castortut/GeneralStepperMotorControllerPCB/README.md

# GeneralStepperMotorControllerPCB
Designed for can opener. Uses Arduino Nano and drv8825 / A4988

# TODO
- The power supply pins are the wrong way around in the PCB!
