castortut/GeneralStepperMotorControllerPCB/canopener.kicad_pcb

## KiCad design canopener.kicad_pcb (2023-08-17)

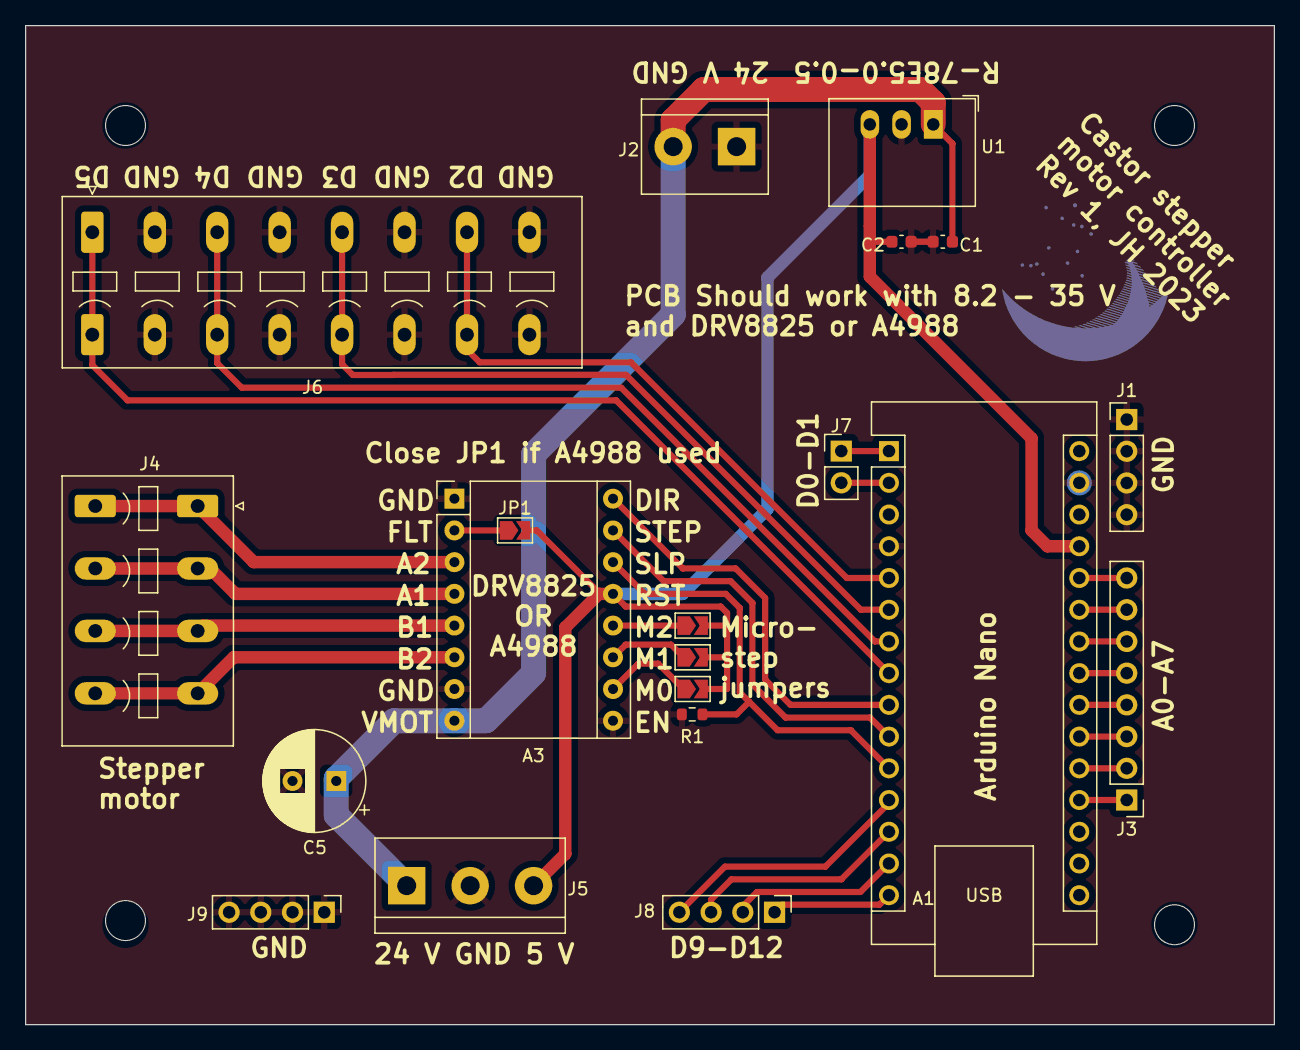
[picture p1: board canopener.kicad_pcb from above]

Board: 2 copper layers, 100.0 x 80.0 mm, 25 parts (1 on the bottom side), 32 nets.

Parts:
A1: Arduino_Nano_v3.x; Arduino_Nano
A3: Pololu_Breakout_DRV8825; Pololu_Breakout-16_15.2x20.3mm
C1, C2: 10u; C_0603_1608Metric
C5: 100u; CP_Radial_D8.0mm_P3.50mm
H1, H2, H3, H4: MountingHole; MountingHole_3.2mm_M3
J1, J8, J9: Conn_01x04; PinHeader_1x04_P2.54mm_Vertical
J2: Screw_Terminal_01x02; TerminalBlock_bornier-2_P5.08mm
J3: Conn_01x08; PinHeader_1x08_P2.54mm_Vertical
J4: Screw_Terminal_01x04; PhoenixContact_SPT_2.5_4-V-5.0-EX_1x04_P5.0mm_Vertical
J5: Screw_Terminal_01x03; TerminalBlock_bornier-3_P5.08mm
J6: Screw_Terminal_01x08; PhoenixContact_SPT_2.5_8-V-5.0-EX_1x08_P5.0mm_Vertical
J7: Conn_01x02; PinHeader_1x02_P2.54mm_Vertical
JP1: Jumper_2_Open; SolderJumper-2_P1.3mm_Open_TrianglePad1.0x1.5mm
LOGO1: CASTOR; Castor logo
M0, M1, M2: Jumper_2_Open; SolderJumper-2_P1.3mm_Open_TrianglePad1.0x1.5mm
R1: R; R_0603_1608Metric
U1: R-78E5.0-0.5; Converter_DCDC_RECOM_R-78E-0.5_THT

Connections:
+5V: A1.27 (+5V), A3.13 (~RST), C2.1, J5.3, JP1.2 (B), M0.2 (B), M1.2 (B), M2.2 (B), U1.3 (OUT)
+24V: A3.8 (VMOT), C1.1, C5.1, J2.2, J5.1, U1.1 (IN)
GND: A1.4 (GND), A1.29 (GND), A3.1 (GND), A3.7 (GND), A3.9 (~EN), C1.2, C2.2, C5.2, J1.1, J1.2, J1.3, J1.4, J2.1, J5.2, J6.2, J6.4, J6.6, J6.8, J9.1, J9.2, J9.3, J9.4, R1.2, U1.2 (GND)
unnamed: A1.19 (A0), J3.1
unnamed: A1.20 (A1), J3.2
unnamed: A1.21 (A2), J3.3
unnamed: A1.22 (A3), J3.4
unnamed: A1.23 (A4), J3.5
unnamed: A1.24 (A5), J3.6
unnamed: A1.25 (A6), J3.7
unnamed: A1.26 (A7), J3.8
unnamed: A1.2 (D0/RX), J7.2
unnamed: A1.1 (D1/TX), J7.1
unnamed: A1.5 (D2), J6.7
unnamed: A1.6 (D3), J6.5
unnamed: A1.7 (D4), J6.3
unnamed: A1.8 (D5), J6.1
unnamed: A1.9 (D6), A3.16 (DIR)
unnamed: A1.10 (D7), A3.15 (STEP)
unnamed: A1.11 (D8), A3.14 (~SLP), R1.1
unnamed: A1.12 (D9), J8.4
unnamed: A1.13 (D10), J8.3
unnamed: A1.14 (D11), J8.2
unnamed: A1.15 (D12), J8.1
unnamed: A3.4 (A1), J4.2
unnamed: A3.3 (A2), J4.1
unnamed: A3.5 (B1), J4.3
unnamed: A3.6 (B2), J4.4
unnamed: A3.10 (M0), M0.1 (A)
unnamed: A3.11 (M1), M1.1 (A)
unnamed: A3.12 (M2), M2.1 (A)
unnamed: A3.2 (~FLT), JP1.1 (A)
