castortut/GeneralStepperMotorControllerPCB/(commit log)

2023-04-14 Add Kicad files
    [canopener.kicad_pcb, canopener.kicad_sch]
2023-04-16 Better version. Added also documentation
    [canopener.kicad_pcb, canopener.kicad_sch]
2023-04-16 Maybe ready :D
    [canopener.kicad_pcb]
2023-04-24 add a small logo
    [canopener.kicad_pcb, canopener.kicad_sch]
2023-08-17 Added Arduino code
